DillonN/ArduinoFanController/(commit log)

2017-02-14 Calculation of RPM fixed
    [fan.ino]
2017-02-14 Button working
2017-04-27 Fixed PWM control glitch (don't monitor digital pins)
